SharhadBashar/ECSE-434-Micro-Electronics/final report/Screen Shot 2015-12-02 at 1.02.28 AM.png

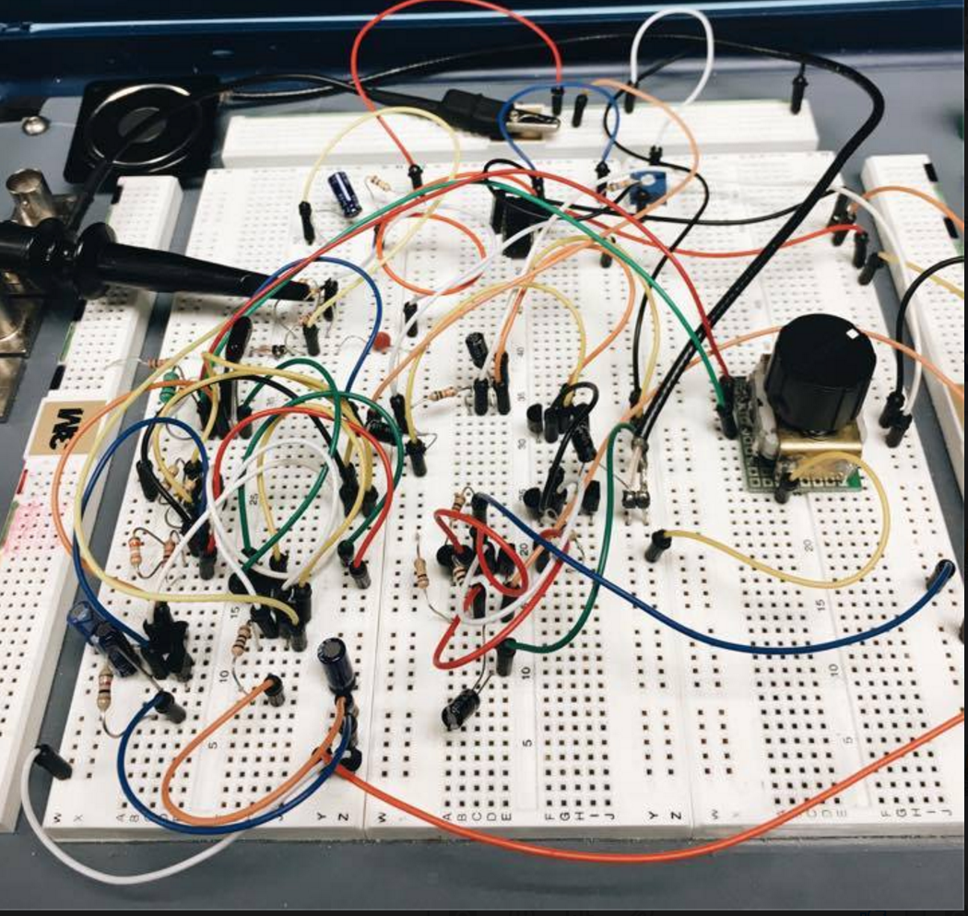
final report/Screen Shot 2015-12-02 at 1.02.28 AM.png
