SharhadBashar/ECSE-434-Micro-Electronics/final report/Screen Shot 2015-12-02 at 12.14.44 AM.png

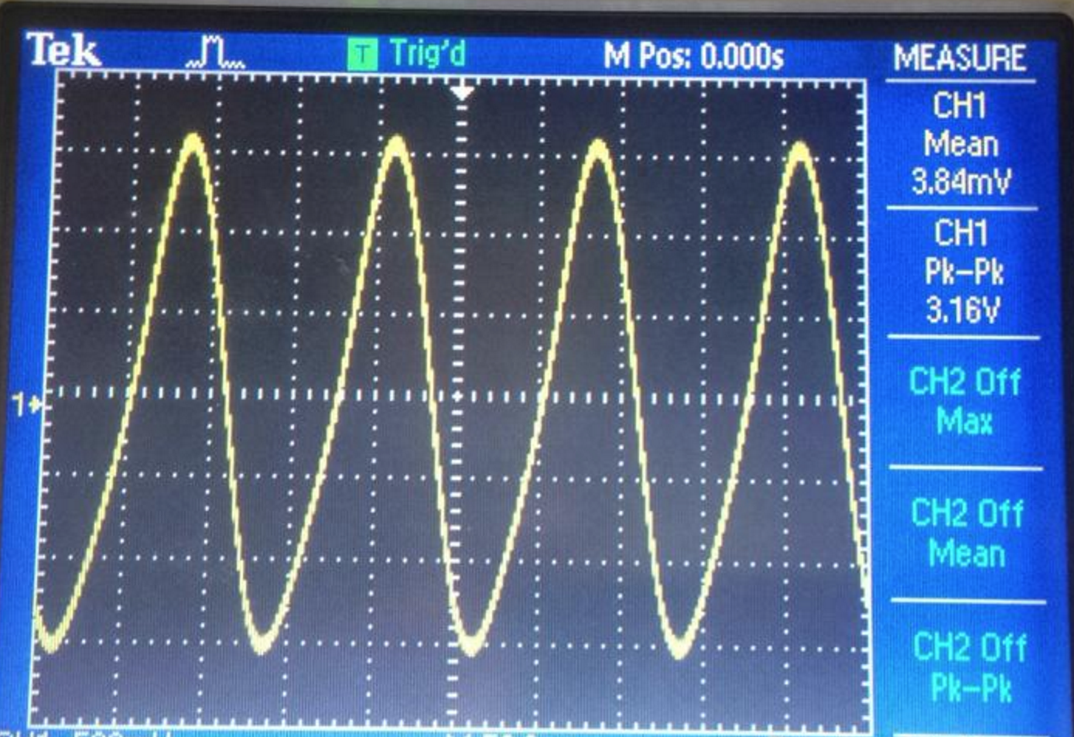
final report/Screen Shot 2015-12-02 at 12.14.44 AM.png
