SharhadBashar/ECSE-434-Micro-Electronics/README.md

# ECSE-434-Micro-Electronics  
Code written in Pspice  
Creating an AM Radio from scratch  
Sharhad Bashar  
Honors Electrical Engineering  
McGill University
