SharhadBashar/ECSE-434-Micro-Electronics/ECSE_434_graphs/TEK0001.JPG

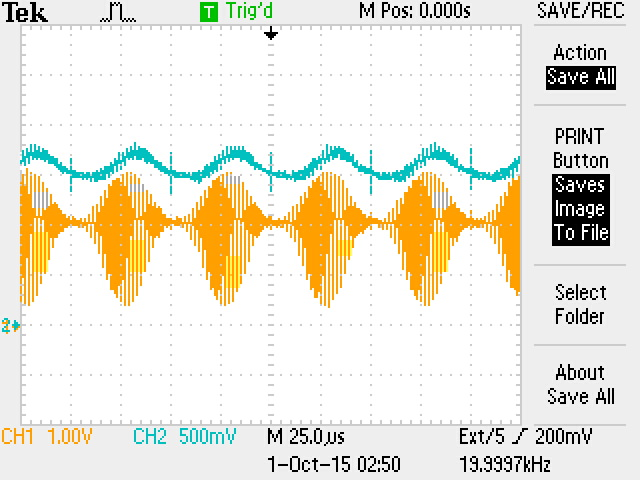
ECSE_434_graphs/TEK0001.JPG
