SharhadBashar/ECSE-434-Micro-Electronics/final report/Screen Shot 2015-12-01 at 2.20.17 AM.png

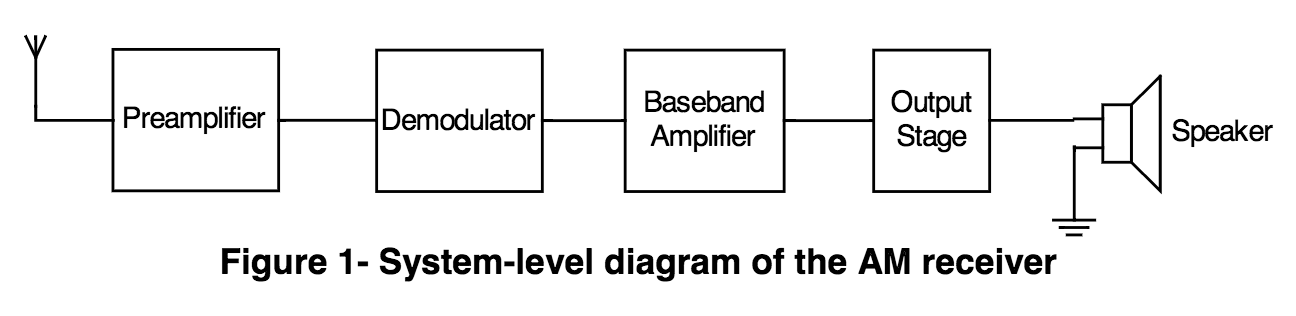
final report/Screen Shot 2015-12-01 at 2.20.17 AM.png
