SharhadBashar/ECSE-434-Micro-Electronics/final report/Screen Shot 2015-12-01 at 11.02.55 PM.png

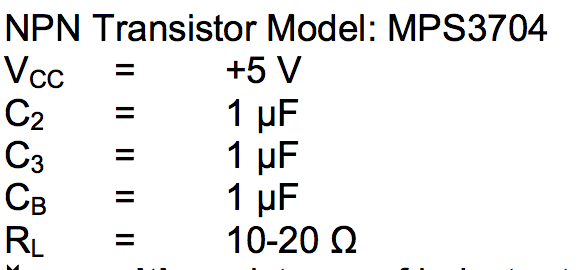
final report/Screen Shot 2015-12-01 at 11.02.55 PM.png
