SharhadBashar/ECSE-434-Micro-Electronics/final report/Screen Shot 2015-12-01 at 11.03.08 PM.png

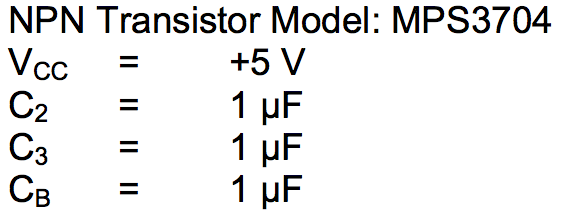
final report/Screen Shot 2015-12-01 at 11.03.08 PM.png
