SharhadBashar/ECSE-434-Micro-Electronics/Prelabs/5.2/all of the output.PNG

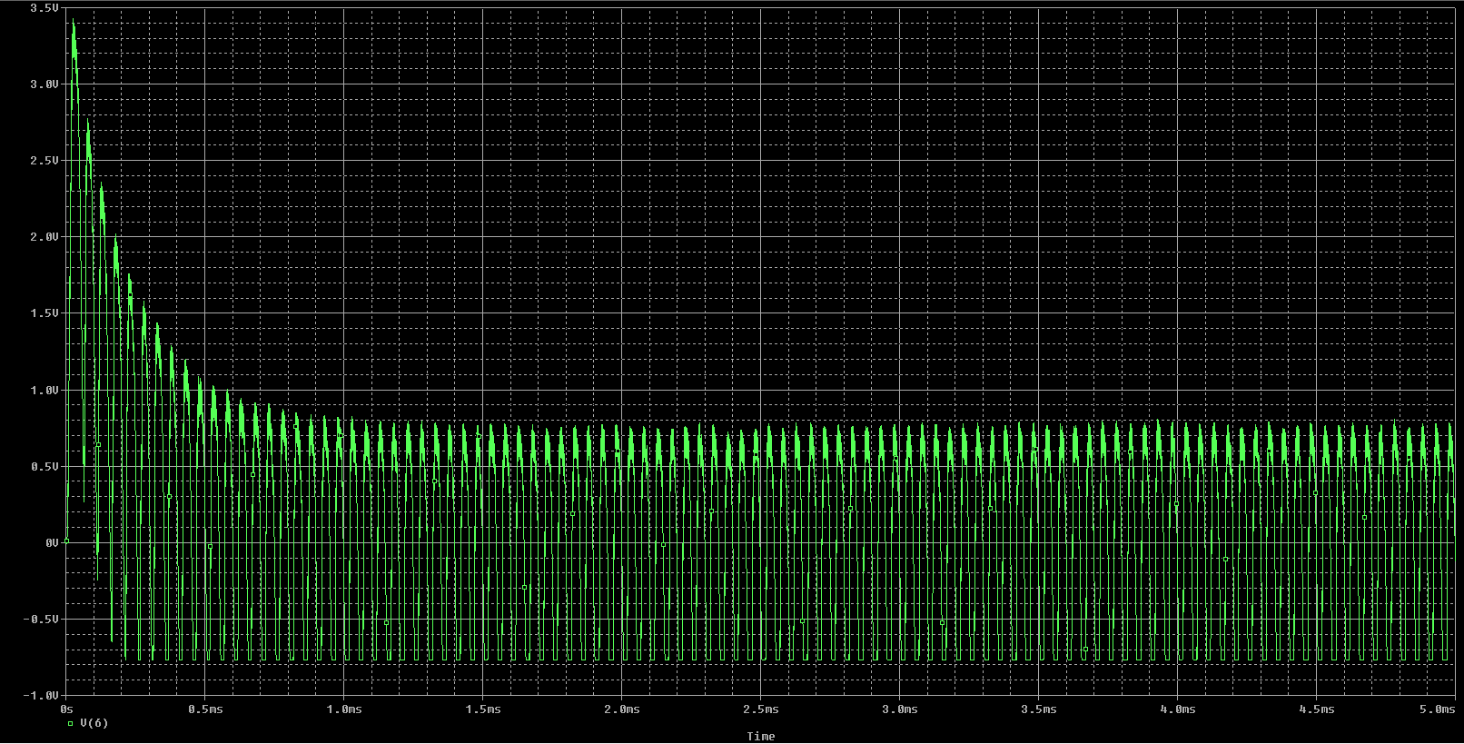
Prelabs/5.2/all of the output.PNG
