SharhadBashar/ECSE-434-Micro-Electronics/Prelabs/5.2/input.PNG

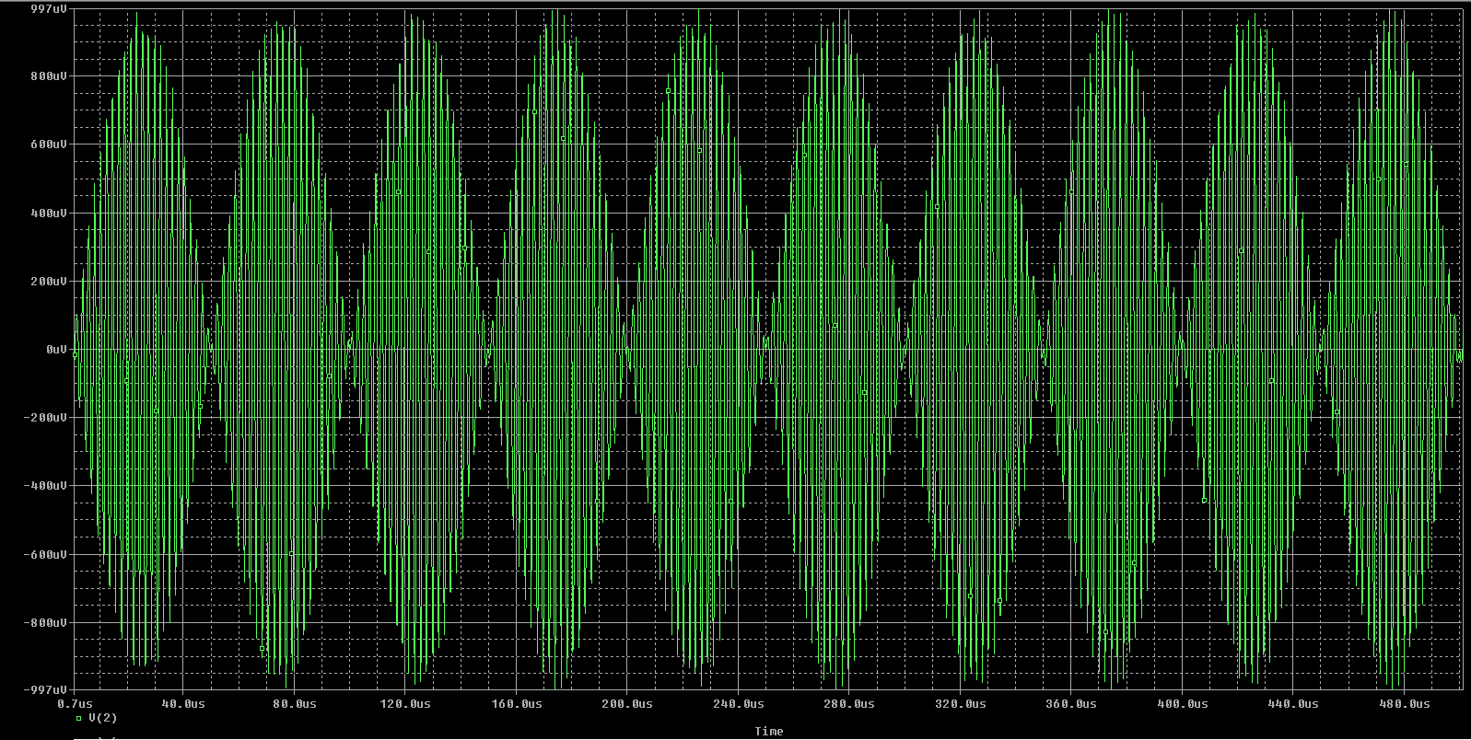
Prelabs/5.2/input.PNG
