SharhadBashar/ECSE-434-Micro-Electronics/Prelabs/5.2/output2.PNG

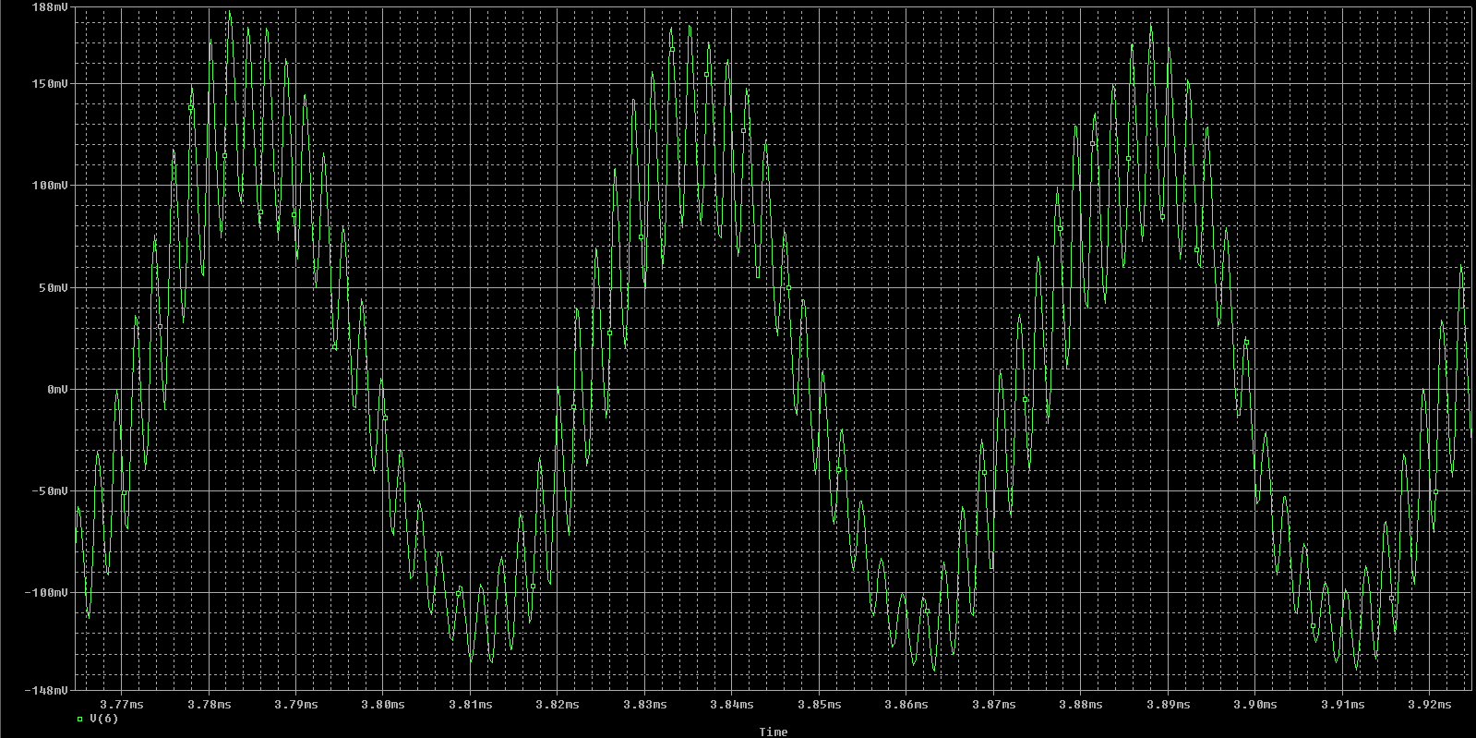
Prelabs/5.2/output2.PNG
