SharhadBashar/ECSE-434-Micro-Electronics/Prelabs/5.2/output 3.PNG

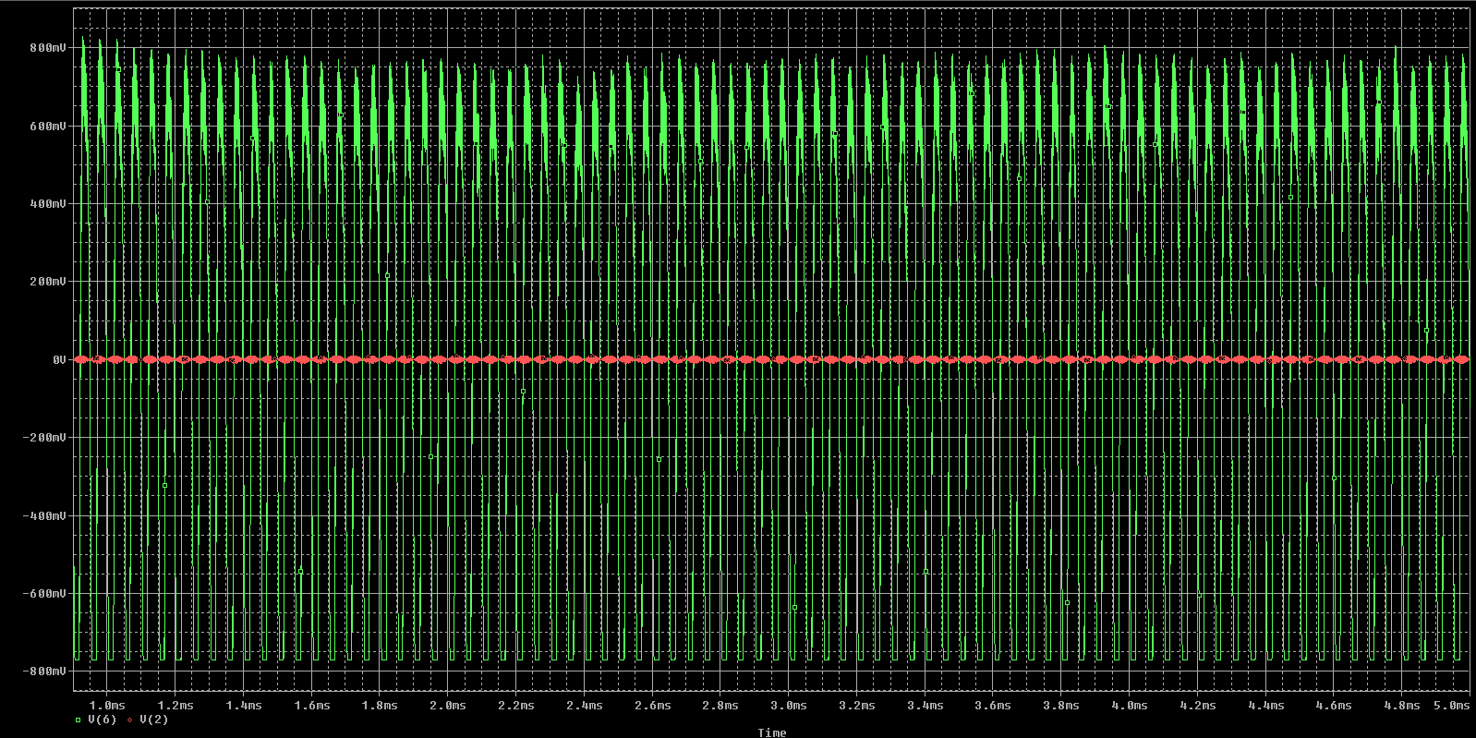
Prelabs/5.2/output 3.PNG
