SharhadBashar/ECSE-434-Micro-Electronics/Prelabs/5.2/output.PNG

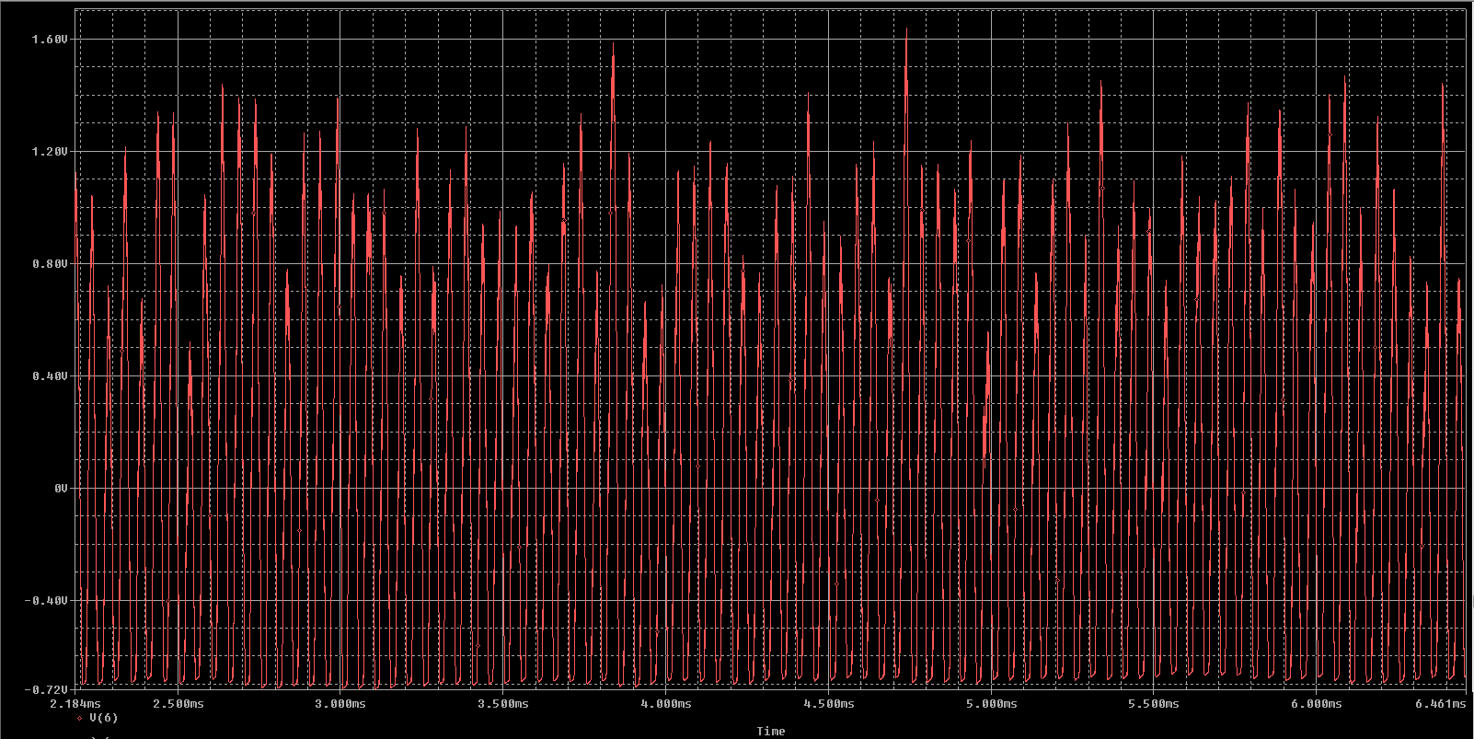
Prelabs/5.2/output.PNG
