SharhadBashar/ECSE-434-Micro-Electronics/Prelabs/6.2/Station.JPG

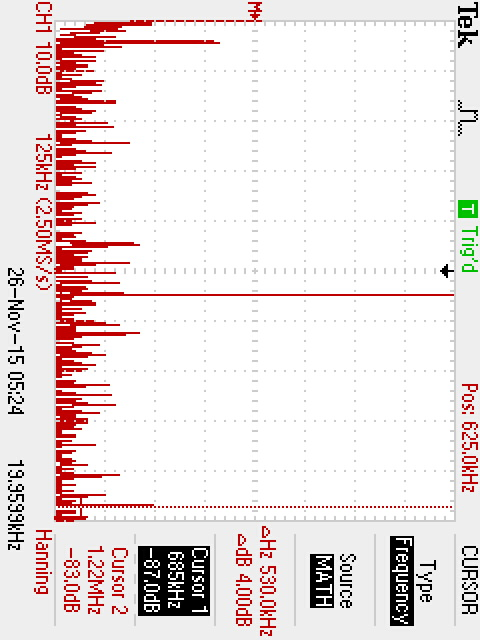
Prelabs/6.2/Station.JPG
