SharhadBashar/ECSE-434-Micro-Electronics/ECSE_434_graphs/Experiment1_Output_Stage_A.xlsx

Small Signal |  |  |  |  | Large Signal
Vin(pk-pk)/mV | Vout /mV | Frequency/Hz | Vout/Vin | Gain(dB) | Vin(pk-pk)/mV | Vout /mV | Frequency/Hz | Vout/Vin | Gain(dB) | Max Voltage = 2.2 Pk-pk
200 | 18 | 50 | 0.09 | -20.91514981 | 0.984 | 0.015 | 10 | 0.01524390244 | -36.33807679 | at 100 KHz
200 | 30 | 100 | 0.15 | -16.47817482 | 0.984 | 0.068 | 50 | 0.06910569106 | -23.20972371
200 | 49 | 200 | 0.245 | -12.21667831 | 0.984 | 0.126 | 100 | 0.1280487805 | -17.85249107
200 | 66 | 300 | 0.33 | -9.629721202 | 0.984 | 0.452 | 500 | 0.4593495935 | -6.757133272
200 | 80 | 400 | 0.4 | -7.958800173 | 0.984 | 0.62 | 1000 | 0.6300813008 | -4.012068179
200 | 92 | 500 | 0.46 | -6.744843366 | 0.984 | 0.716 | 2000 | 0.7276422764 | -2.761641522
200 | 102 | 600 | 0.51 | -5.848596478 | 0.984 | 0.768 | 3000 | 0.7804878049 | -2.152677568
200 | 110 | 700 | 0.55 | -5.19274621 | 0.984 | 0.784 | 4000 | 0.7967479675 | -1.973580715
200 | 118 | 800 | 0.59 | -4.582959767 | 0.984 | 0.784 | 5000 | 0.7967479675 | -1.973580715
200 | 122 | 900 | 0.61 | -4.2934033 | 0.984 | 0.8 | 10000 | 0.8130081301 | -1.798102229
200 | 127 | 1000 | 0.635 | -3.944525494 | 0.984 | 0.8 | 20000 | 0.8130081301 | -1.798102229
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
