SharhadBashar/ECSE-434-Micro-Electronics/(list of files, drawings)

Other design files:
Device Models/bipolar/BIPOLAR.OLB
Device Models/diode/DIODE.OLB
Device Models/Gennum Libraries/ga911.olb
Device Models/Gennum Libraries/ga911res.olb
Device Models/opamp/opamp.olb
